yusufElnady/NadyScope/NadyScope.kicad_pcb

## KiCad design NadyScope.kicad_pcb (2026-04-17)

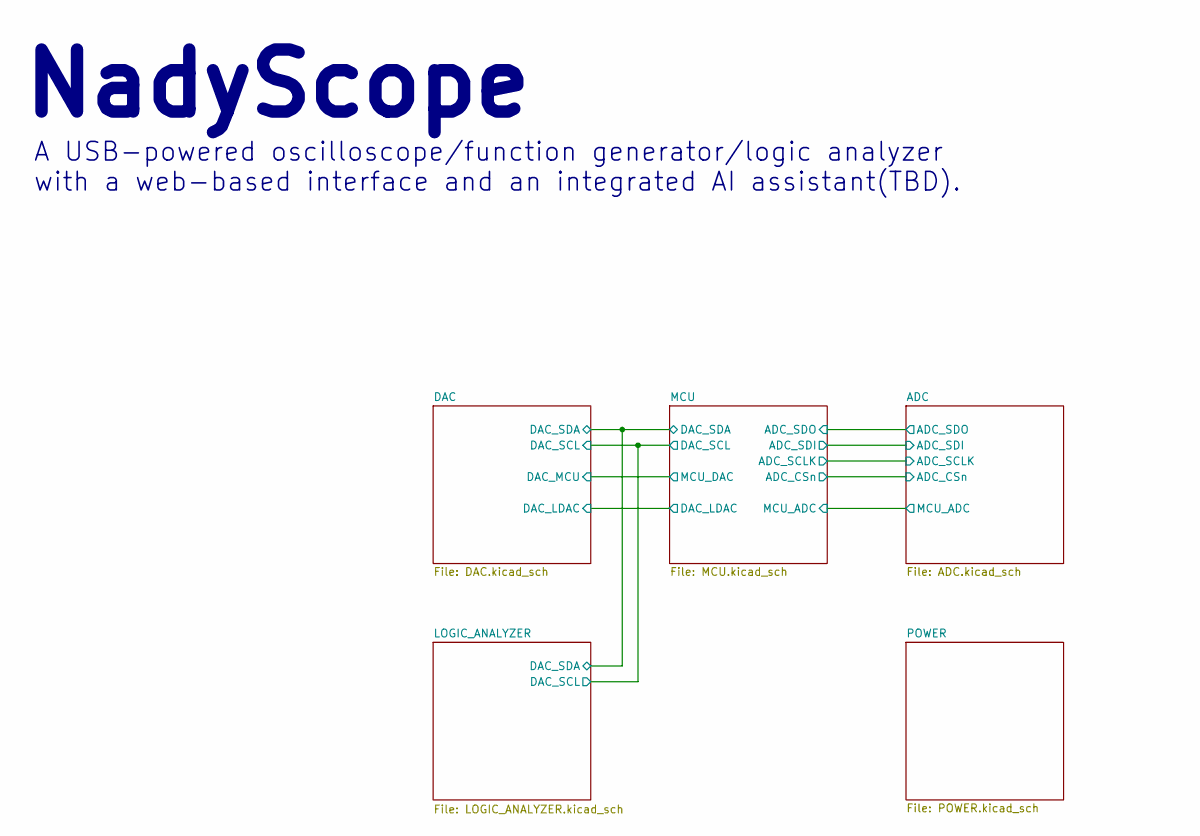
[picture p10: schematic NadyScope.kicad_sch]

Notes on the sheet:
A USB-powered oscilloscope/function generator/logic analyzer with a web-based interface and an integrated AI assistant(TBD).
NadyScope

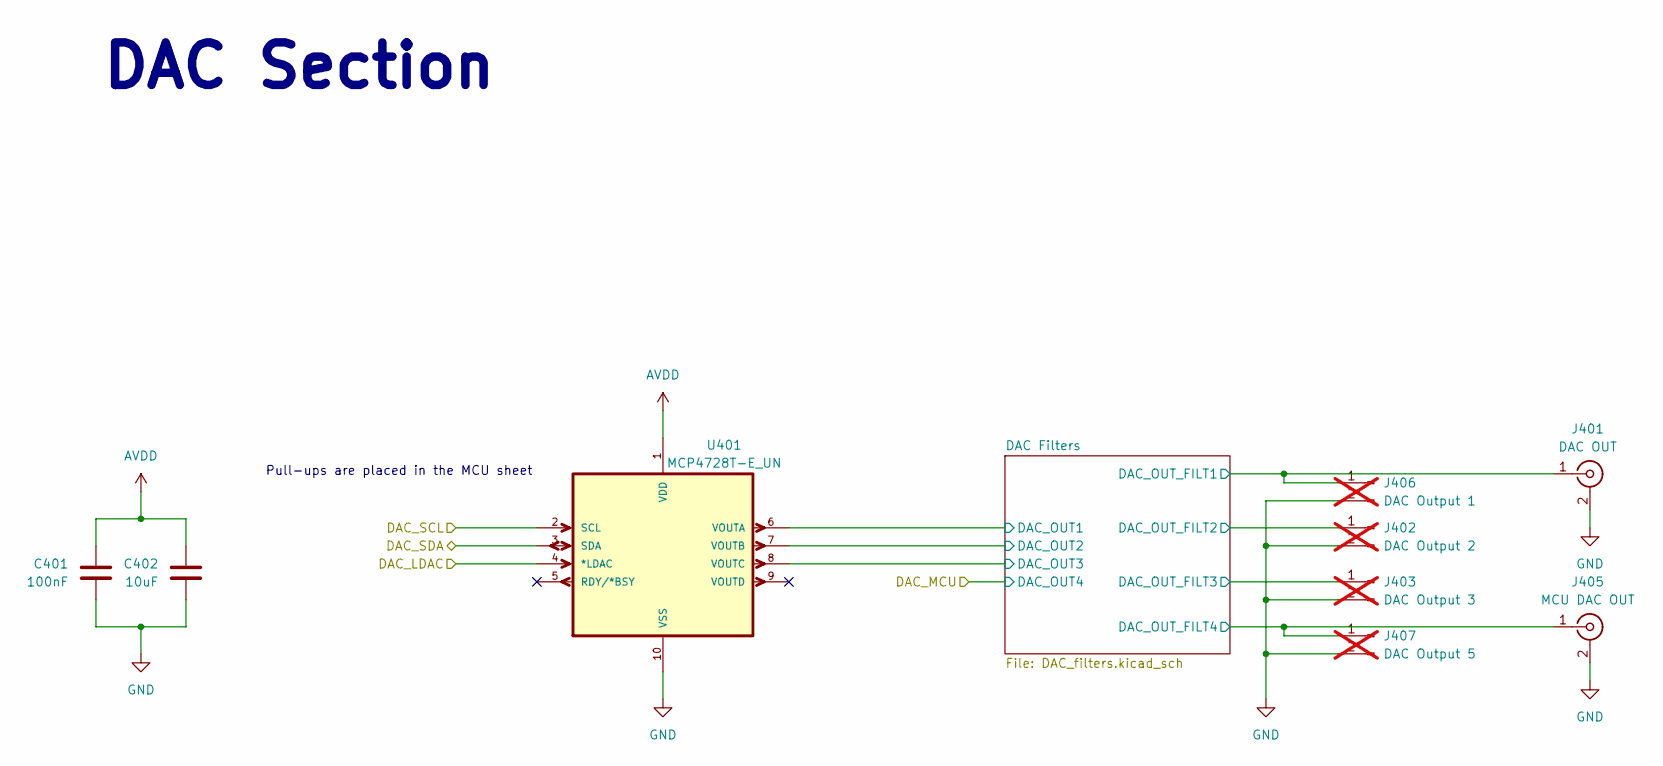
[picture p11: schematic DAC.kicad_sch]

Parts:
C401: 100nF; C_0603_1608Metric; MPN 0603B104M250CT
C402: 10uF; C_0603_1608Metric; MPN CL10A106MP8NNNC
J401: DAC OUT; CONN4_DOSIN-801_DOS; MPN DOSIN-801-0083
J402: DAC Output 2; PinHeader_1x02_P2.54mm_Vertical; not fitted
J403: DAC Output 3; PinHeader_1x02_P2.54mm_Vertical; not fitted
J405: MCU DAC OUT; CONN4_DOSIN-801_DOS; MPN DOSIN-801-0083
J406: DAC Output 1; PinHeader_1x02_P2.54mm_Vertical; not fitted
J407: DAC Output 5; PinHeader_1x02_P2.54mm_Vertical; not fitted
U401: MCP4728T-E_UN; SOP50P490X110-10N; MPN MCP4728T-E/UN

Connections:
/DAC/DAC Filters/DAC_OUT1: U401.6 (VOUTA); also elsewhere on the board
/DAC/DAC Filters/DAC_OUT2: U401.7 (VOUTB); also elsewhere on the board
/DAC/DAC Filters/DAC_OUT3: U401.8 (VOUTC); also elsewhere on the board
/DAC/DAC Filters/DAC_OUT_FILT1: J401.1 (In), J406.1; also elsewhere on the board
/DAC/DAC Filters/DAC_OUT_FILT2: J402.1; also elsewhere on the board
/DAC/DAC Filters/DAC_OUT_FILT3: J403.1; also elsewhere on the board
/DAC/DAC Filters/DAC_OUT_FILT4: J405.1 (In), J407.1; also elsewhere on the board
/DAC/DAC_LDAC: U401.4 (*LDAC); also elsewhere on the board
/DAC/DAC_SCL: U401.2 (SCL); also elsewhere on the board
/DAC/DAC_SDA: U401.3 (SDA); also elsewhere on the board
AVDD: C401.1, C402.1, U401.1 (VDD); also elsewhere on the board
GND: C401.2, C402.2, J401.2 (Ext), J402.2, J403.2, J405.2 (Ext), J406.2, J407.2, U401.10 (VSS); also elsewhere on the board

Notes on the sheet:
DAC Section
Pull-ups are placed in the MCU sheet

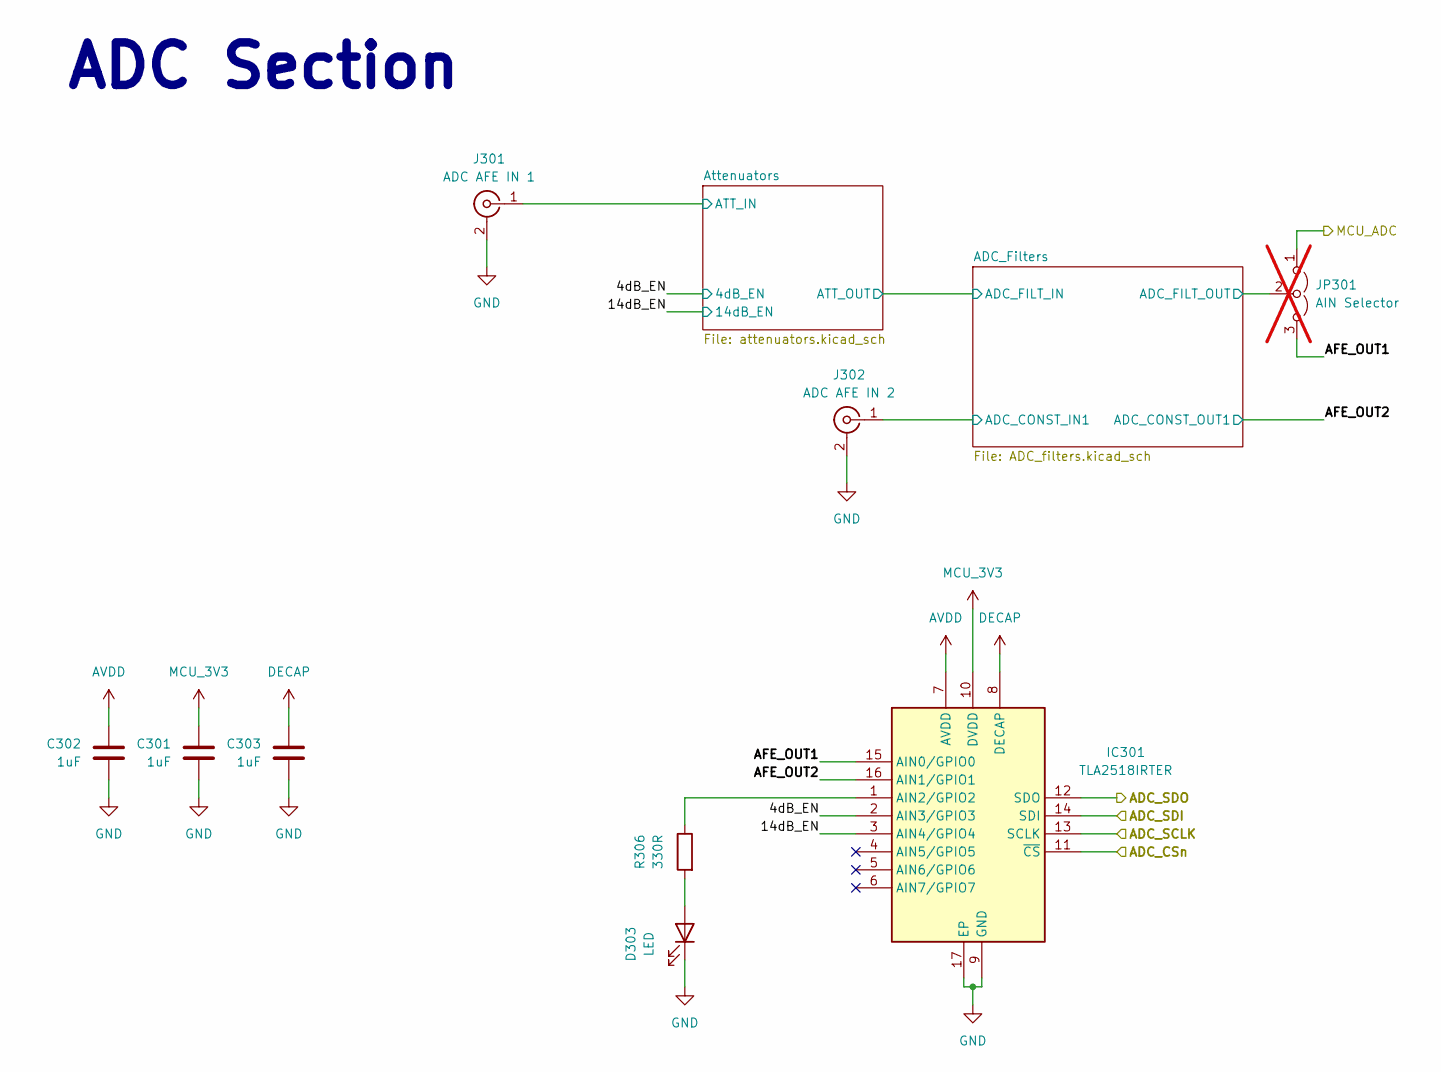
[picture p12: schematic ADC.kicad_sch, Input Analog Frontend Section]

Parts:
C301, C302, C303: 1uF; C_0603_1608Metric; MPN 0603X105K250CT
D303: LED; LED_0805_2012Metric
IC301: TLA2518IRTER; QFN50P300X300X80-17N-D; Manufacturer_Part_Number TLA2518IRTER; Mouser Part Number 595-TLA2518IRTER
J301: ADC AFE IN 1; CONN4_DOSIN-801_DOS; MPN DOSIN-801-0083
J302: ADC AFE IN 2; CONN4_DOSIN-801_DOS; MPN DOSIN-801-0083
JP301: AIN Selector; SolderJumper-3_P1.3mm_Open_Pad1.0x1.5mm; not fitted
R306: 330R; R_0603_1608Metric; MPN TD03G3300BT

Connections:
/ADC/4dB_EN: IC301.2 (AIN3/GPIO3); also elsewhere on the board
/ADC/14dB_EN: IC301.3 (AIN4/GPIO4); also elsewhere on the board
/ADC/ADC_CSn: IC301.11 (~CS); also elsewhere on the board
/ADC/ADC_Filters/ADC_FILT_OUT: JP301.2 (C); also elsewhere on the board
/ADC/ADC_SCLK: IC301.13 (SCLK); also elsewhere on the board
/ADC/ADC_SDI: IC301.14 (SDI); also elsewhere on the board
/ADC/ADC_SDO: IC301.12 (SDO); also elsewhere on the board
/ADC/AFE_OUT1: IC301.15 (AIN0/GPIO0), JP301.3 (B)
/ADC/AFE_OUT2: IC301.16 (AIN1/GPIO1); also elsewhere on the board
/ADC/MCU_ADC: JP301.1 (A); also elsewhere on the board
AVDD: C302.1, IC301.7 (AVDD); also elsewhere on the board
DECAP: C303.1, IC301.8 (DECAP)
GND: C301.2, C302.2, C303.2, D303.1 (K), IC301.9 (GND), IC301.17 (EP), J301.2 (Ext), J302.2 (Ext); also elsewhere on the board
MCU_3V3: C301.1, IC301.10 (DVDD); also elsewhere on the board
unnamed: D303.2 (A), R306.2
unnamed: IC301.1 (AIN2/GPIO2), R306.1

Notes on the sheet:
ADC Section

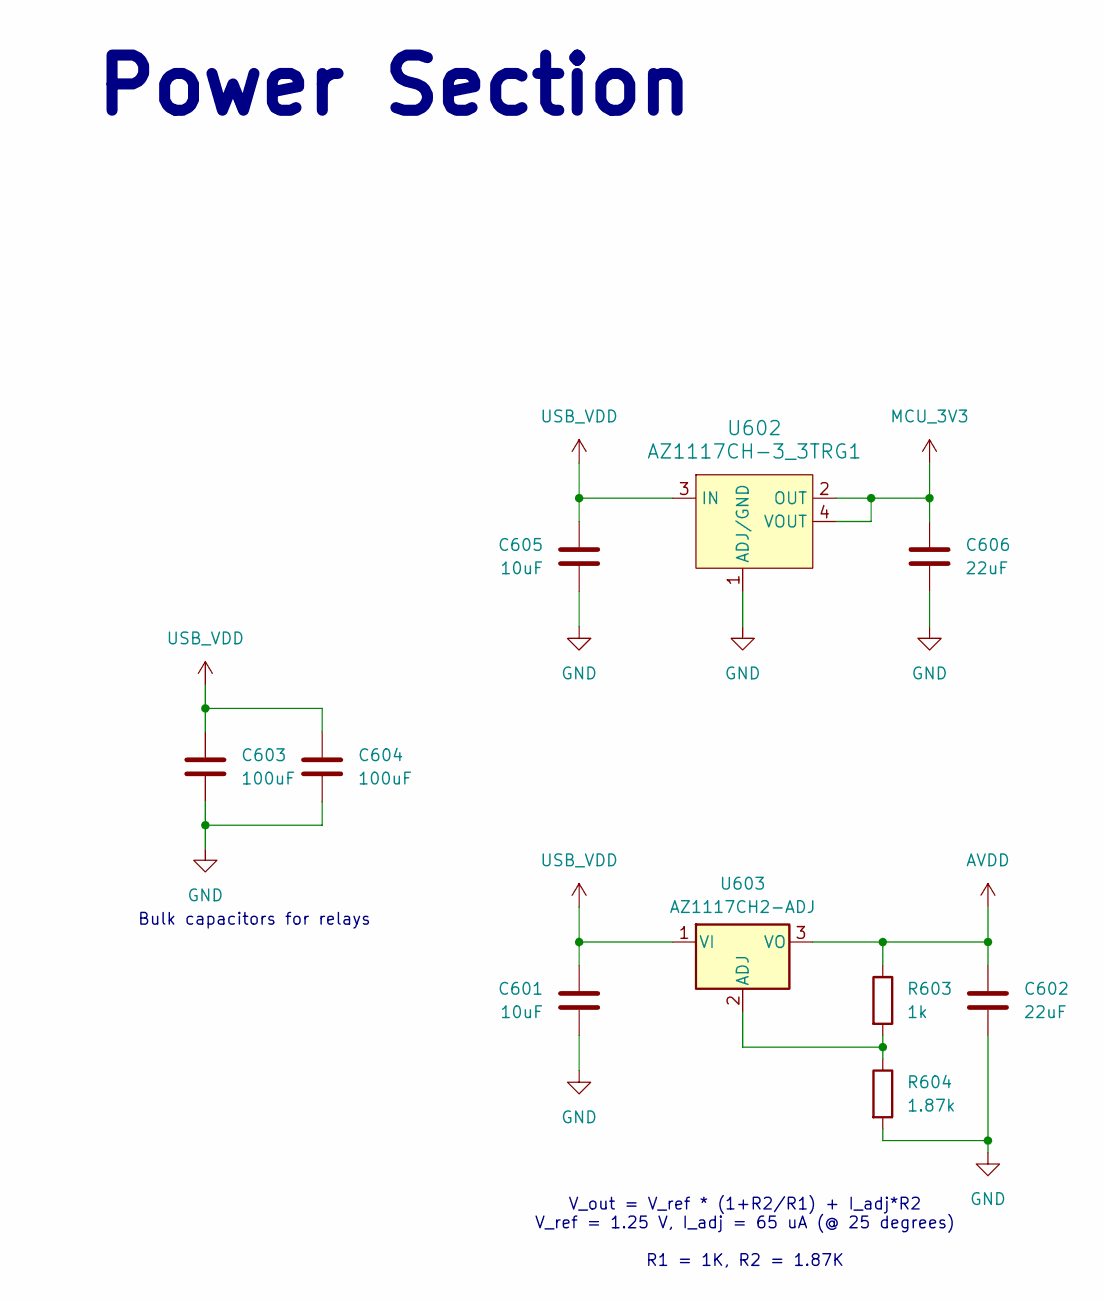
[picture p13: schematic POWER.kicad_sch]

Parts:
C601, C605: 10uF; C_0805_2012Metric; MPN CL21A106KOQNNNE
C602, C606: 22uF; C_0805_2012Metric; MPN CL21X226MRQNNNE
C603, C604: 100uF; C_1206_3216Metric; MPN TCC1206X7R103M501DTS
R603: 1k; R_0603_1608Metric; MPN RT0603BRD071KL
R604: 1.87k; R_0603_1608Metric; MPN PTFR0603B1K87N9
U602: AZ1117CH-3_3TRG1; SOT-223; MPN AZ1117CH-3.3TRG1; Digi-Key_PN AZ1117CH-3.3TRG1DICT-ND
U603: AZ1117CH2-ADJ; SOT-223-3_TabPin2; MPN AZ1117CH2-ADJ

Connections:
AVDD: C602.1, R603.1, U603.3 (VO); also elsewhere on the board
GND: C601.2, C602.2, C603.2, C604.2, C605.2, C606.2, R604.2, U602.1 (ADJ/GND); also elsewhere on the board
MCU_3V3: C606.1, U602.2 (OUT), U602.4 (VOUT); also elsewhere on the board
unnamed: R603.2, R604.1, U603.2 (ADJ)
USB_VDD: C601.1, C603.1, C604.1, C605.1, U602.3 (IN), U603.1 (VI); also elsewhere on the board

Notes on the sheet:
Bulk capacitors for relays
V_out = V_ref * (1+R2/R1) + I_adj*R2 V_ref = 1.25 V, I_adj = 65 uA (@ 25 degrees) R1 = 1K, R2 = 1.87K
Power Section

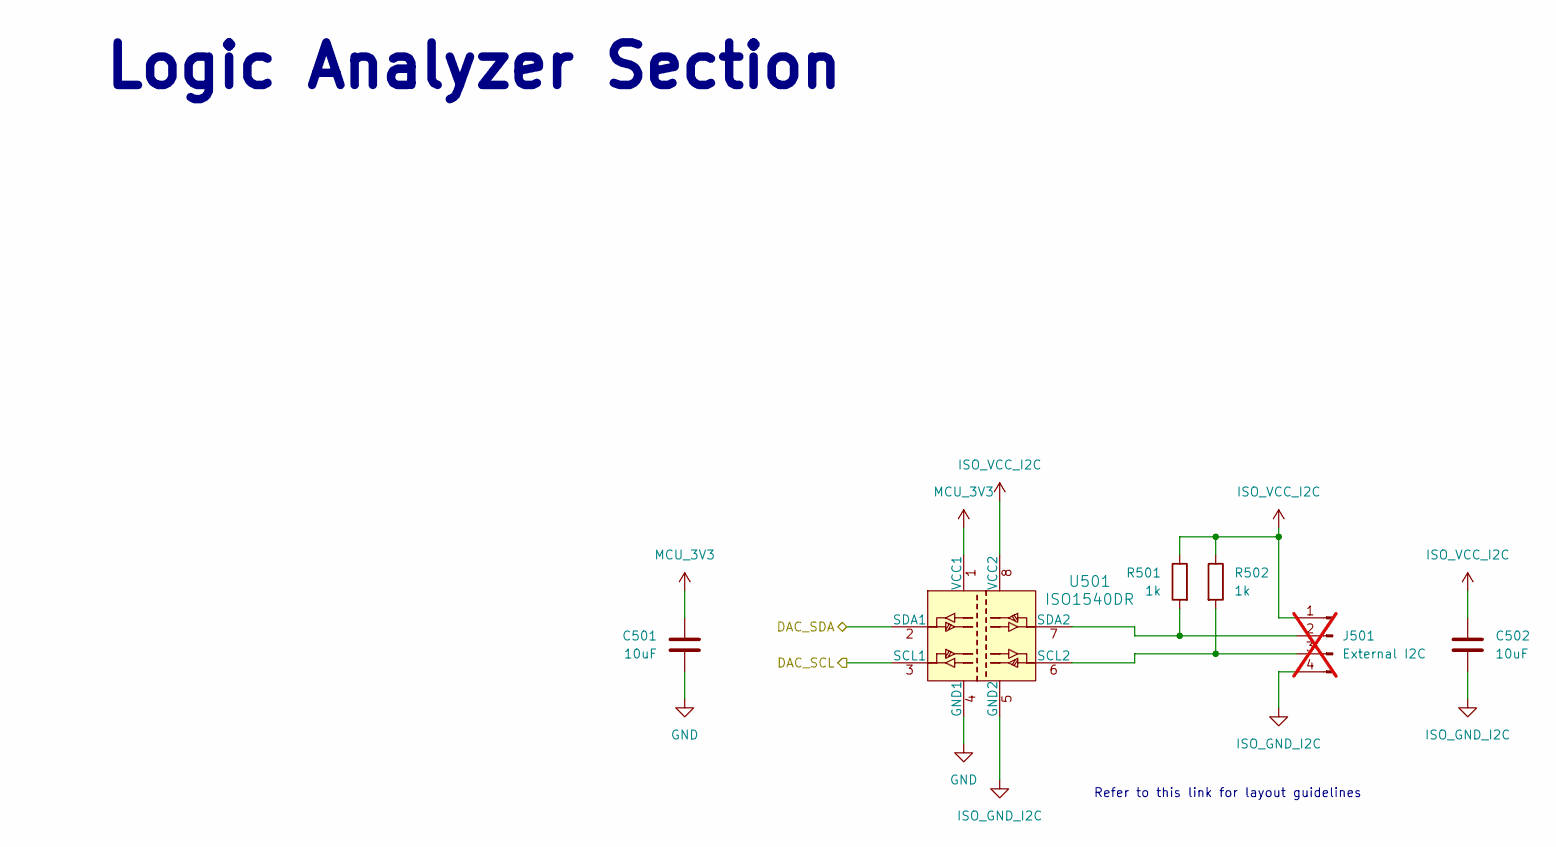
[picture p14: schematic LOGIC_ANALYZER.kicad_sch]

Parts:
C501, C502: 10uF; C_0603_1608Metric; MPN CL10A106MP8NNNC
J501: External I2C; PinHeader_1x04_P2.54mm_Vertical; not fitted
R501, R502: 1k; R_0603_1608Metric; MPN RT0603BRD071KL
U501: ISO1540DR; SOIC-8_W3.9mm; MPN ISO1540DR; Digi-Key_PN 296-34871-1-ND

Connections:
/DAC/DAC_SCL: U501.3 (SCL1); also elsewhere on the board
/DAC/DAC_SDA: U501.2 (SDA1); also elsewhere on the board
GND: C501.2, U501.4 (GND1); also elsewhere on the board
ISO_GND_I2C: C502.2, J501.4, U501.5 (GND2)
ISO_VCC_I2C: C502.1, J501.1, R501.1, R502.1, U501.8 (VCC2)
MCU_3V3: C501.1, U501.1 (VCC1); also elsewhere on the board
unnamed: J501.2, R501.2, U501.7 (SDA2)
unnamed: J501.3, R502.2, U501.6 (SCL2)

Notes on the sheet:
Logic Analyzer Section
Refer to this link for layout guidelines

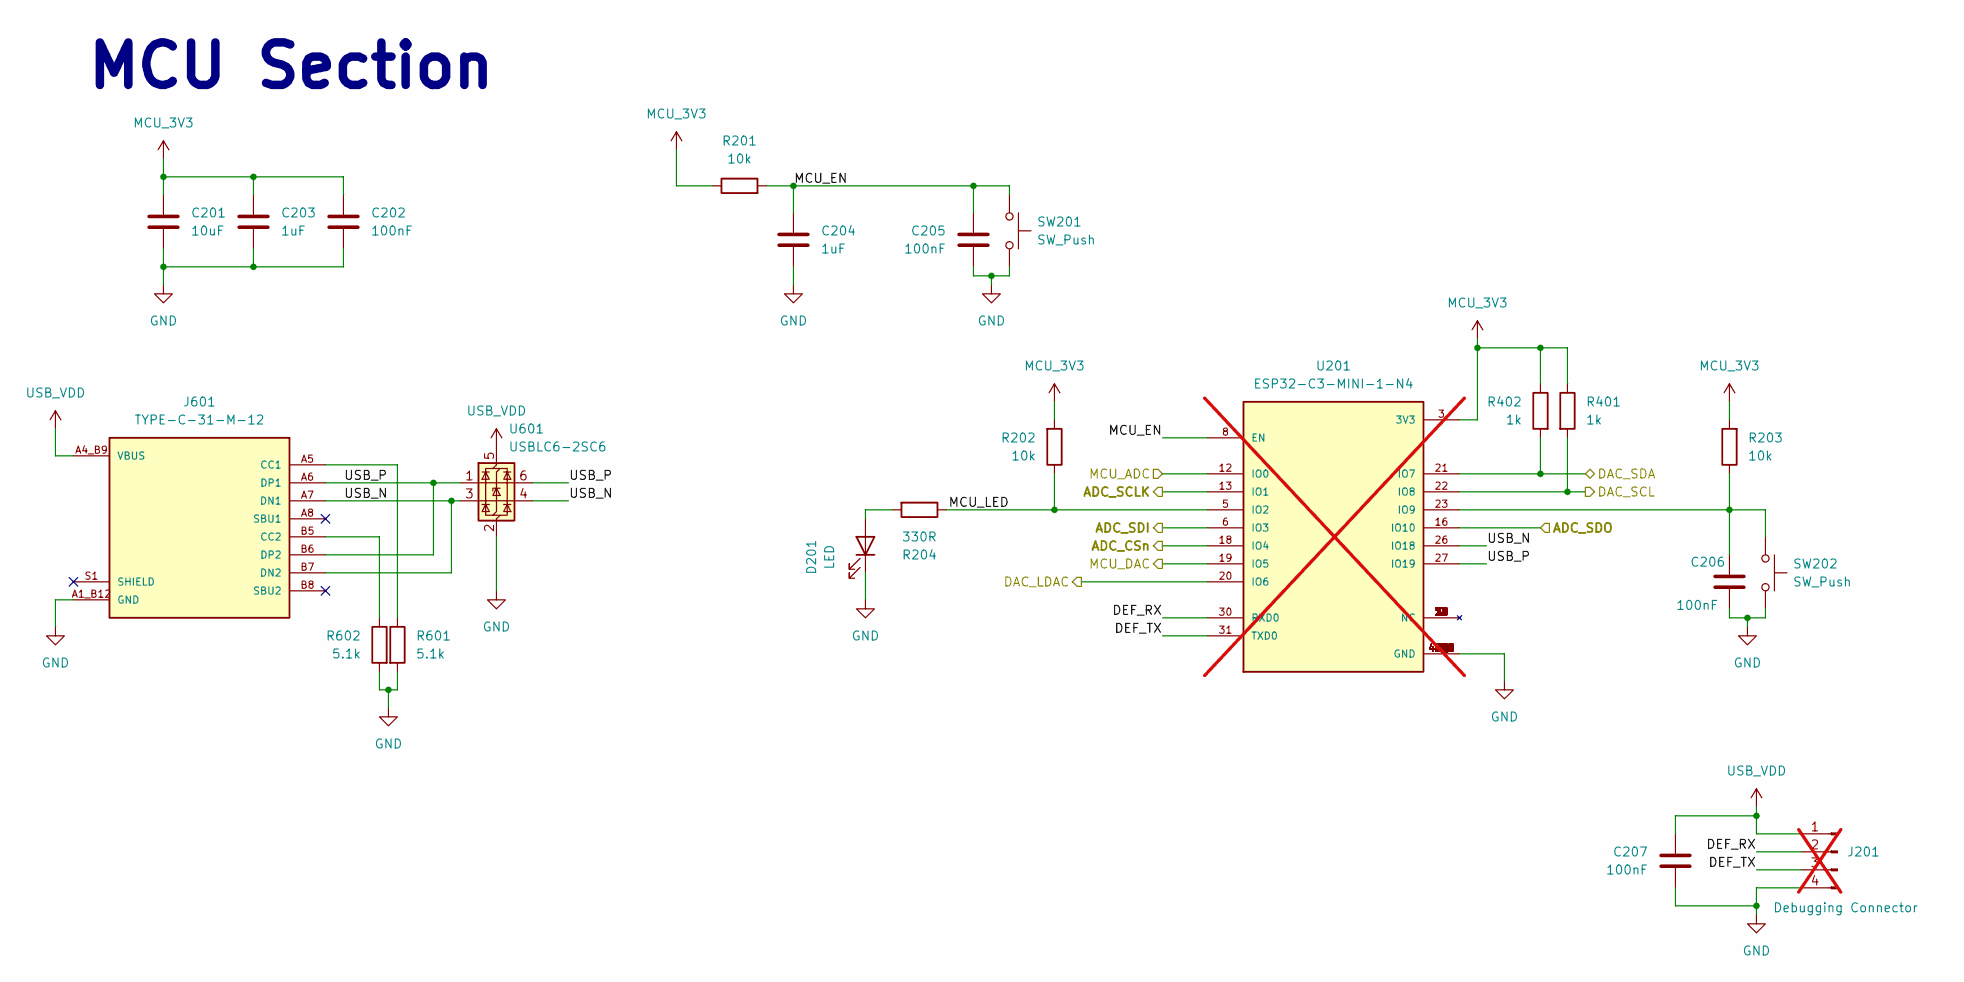
[picture p15: schematic MCU.kicad_sch]

Parts:
C201: 10uF; C_0603_1608Metric; MPN CL10A106MP8NNNC
C202, C205, C206, C207: 100nF; C_0603_1608Metric; MPN 0603B104M250CT
C203, C204: 1uF; C_0603_1608Metric; MPN 0603X105K250CT
D201: LED; LED_0805_2012Metric
J201: Debugging Connector; PinHeader_1x04_P2.54mm_Vertical; not fitted
J601: TYPE-C-31-M-12; HRO_TYPE-C-31-M-12; PARTREV 2020.12.08
R201, R202, R203: 10k; R_0603_1608Metric; MPN TD03G1002BT
R204: 330R; R_0603_1608Metric; MPN TD03G3300BT
R401, R402: 1k; R_0603_1608Metric; MPN RT0603BRD071KL
R601, R602: 5.1k; R_0603_1608Metric; MPN RT0603BRD075K1L
SW201, SW202: SW_Push; SW_Push_SPST_NO_Alps_SKRK
U201: ESP32-C3-MINI-1-N4; XCVR_ESP32-C3-MINI-1-N4; PARTREV v1.0; not fitted
U601: USBLC6-2SC6; SOT-23-6; MPN USBLC6-2SC6

Connections:
/ADC/ADC_CSn: U201.18 (IO4); also elsewhere on the board
/ADC/ADC_SCLK: U201.13 (IO1); also elsewhere on the board
/ADC/ADC_SDI: U201.6 (IO3); also elsewhere on the board
/ADC/ADC_SDO: U201.16 (IO10); also elsewhere on the board
/ADC/MCU_ADC: U201.12 (IO0); also elsewhere on the board
/DAC/DAC_LDAC: U201.20 (IO6); also elsewhere on the board
/DAC/DAC_MCU: U201.19 (IO5); also elsewhere on the board
/DAC/DAC_SCL: R401.2, U201.22 (IO8); also elsewhere on the board
/DAC/DAC_SDA: R402.2, U201.21 (IO7); also elsewhere on the board
/MCU/DEF_RX: J201.2, U201.30 (RXD0)
/MCU/DEF_TX: J201.3, U201.31 (TXD0)
/MCU/MCU_EN: C204.1, C205.1, R201.2, SW201.1, U201.8 (EN)
/MCU/MCU_LED: R202.1, R204.1, U201.5 (IO2)
/MCU/USB_N: J601.A7 (DN1), J601.B7 (DN2), U201.26 (IO18), U601.3 (I/O2), U601.4 (I/O2)
/MCU/USB_P: J601.A6 (DP1), J601.B6 (DP2), U201.27 (IO19), U601.1 (I/O1), U601.6 (I/O1)
GND: C201.2, C202.2, C203.2, C204.2, C205.2, C206.2, C207.2, D201.1 (K), J201.4, J601.A1_B12 (GND), J601.B1_A12 (GND), R601.2, R602.2, SW201.2, SW202.2, U201.1 (GND), U201.2 (GND), U201.11 (GND), U201.14 (GND), U201.36 (GND), U201.37 (GND), U201.38 (GND), U201.39 (GND), U201.40 (GND), U201.41 (GND), U201.42 (GND), U201.43 (GND), U201.44 (GND), U201.45 (GND), U201.46 (GND), U201.47 (GND), U201.48 (GND), U201.49_1 (GND), U201.49_2 (GND), U201.49_3 (GND), U201.49_4 (GND), U201.49_5 (GND), U201.49_6 (GND), U201.49_7 (GND), U201.49_8 (GND), U201.49_9 (GND), U201.50 (GND), U201.51 (GND), U201.52 (GND), U201.53 (GND), U601.2 (GND); also elsewhere on the board
MCU_3V3: C201.1, C202.1, C203.1, R201.1, R202.2, R203.2, R401.1, R402.1, U201.3 (3V3); also elsewhere on the board
unnamed: D201.2 (A), R204.2
unnamed: J601.A5 (CC1), R601.1
unnamed: J601.B5 (CC2), R602.1
unnamed: C206.1, R203.1, SW202.1, U201.23 (IO9)
USB_VDD: C207.1, J201.1, J601.A4_B9 (VBUS), J601.B4_A9 (VBUS), U601.5 (VBUS); also elsewhere on the board

Notes on the sheet:
MCU Section

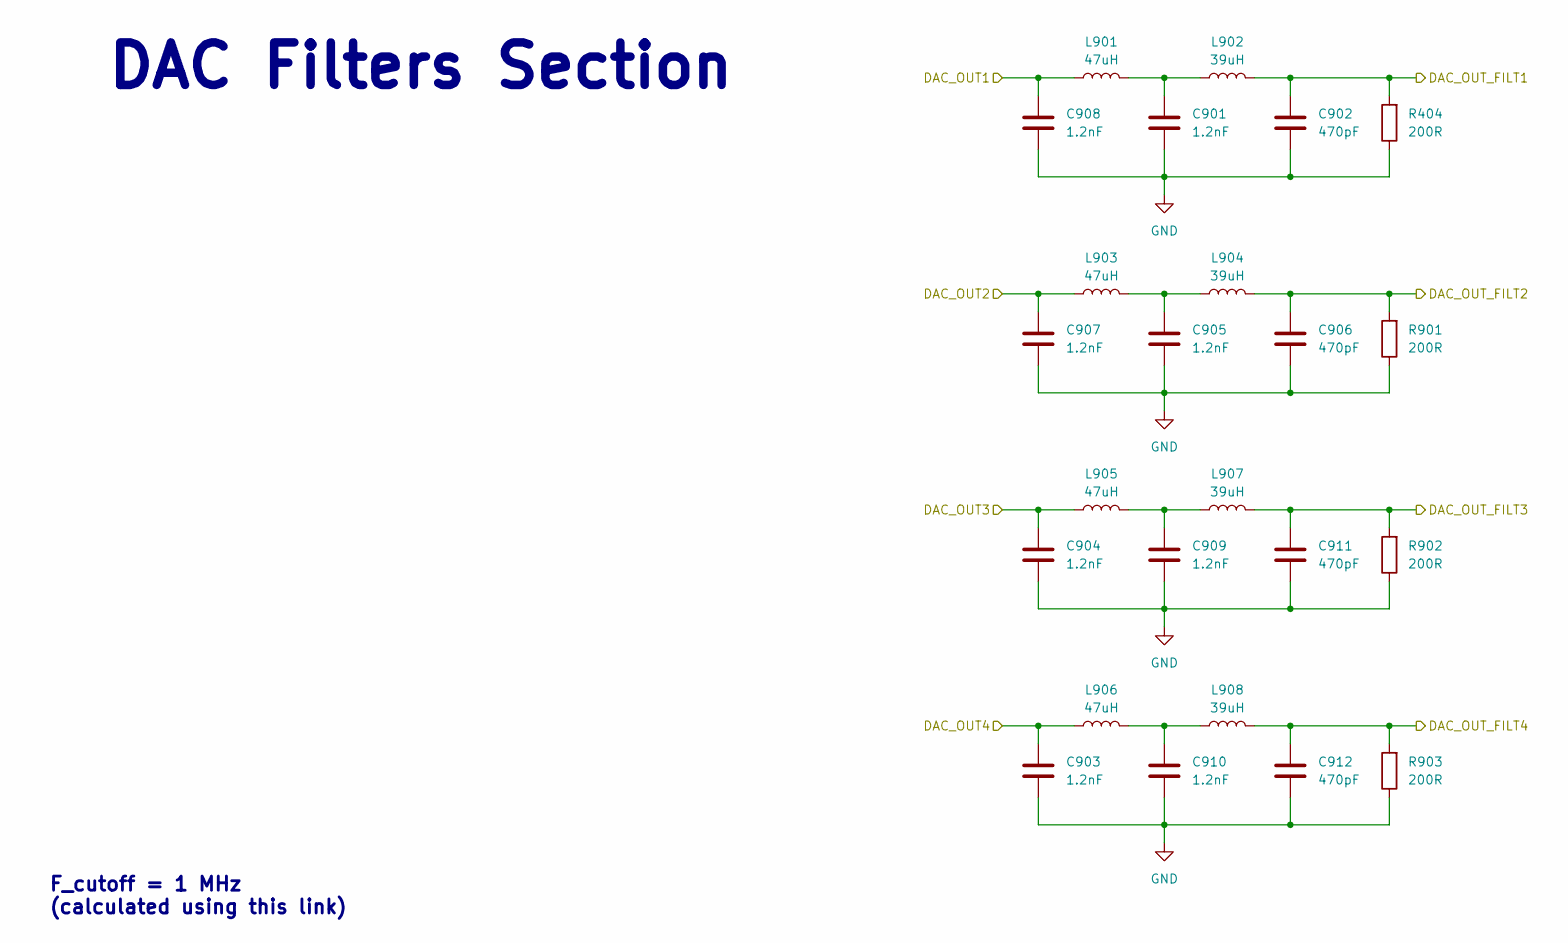
[picture p16: schematic DAC_filters.kicad_sch]

Parts:
C901, C903, C904, C905, C907, C908, C909, C910: 1.2nF; C_0603_1608Metric; MPN CGA0603X7R122K500JT
C902, C906, C911, C912: 470pF; C_0603_1608Metric; MPN FCC0603B471K500CT
L901, L903, L905, L906: 47uH; L_0603_1608Metric; MPN WI0603LD470KST-HF
L902, L904, L907, L908: 39uH; L_0805_2012Metric; MPN MLI2012F-390KT
R404, R901, R902, R903: 200R; R_0603_1608Metric; MPN PTFR0603B200RP9

Connections:
/DAC/DAC Filters/DAC_OUT1: C908.1, L901.1; also elsewhere on the board
/DAC/DAC Filters/DAC_OUT2: C907.1, L903.1; also elsewhere on the board
/DAC/DAC Filters/DAC_OUT3: C904.1, L905.1; also elsewhere on the board
/DAC/DAC Filters/DAC_OUT_FILT1: C902.1, L902.2, R404.2; also elsewhere on the board
/DAC/DAC Filters/DAC_OUT_FILT2: C906.1, L904.2, R901.2; also elsewhere on the board
/DAC/DAC Filters/DAC_OUT_FILT3: C911.1, L907.2, R902.2; also elsewhere on the board
/DAC/DAC Filters/DAC_OUT_FILT4: C912.1, L908.2, R903.2; also elsewhere on the board
/DAC/DAC_MCU: C903.1, L906.1; also elsewhere on the board
GND: C901.2, C902.2, C903.2, C904.2, C905.2, C906.2, C907.2, C908.2, C909.2, C910.2, C911.2, C912.2, R404.1, R901.1, R902.1, R903.1; also elsewhere on the board
unnamed: C901.1, L901.2, L902.1
unnamed: C905.1, L903.2, L904.1
unnamed: C909.1, L905.2, L907.1
unnamed: C910.1, L906.2, L908.1

Notes on the sheet:
F_cutoff = 1 MHz (calculated using this link)
DAC Filters Section

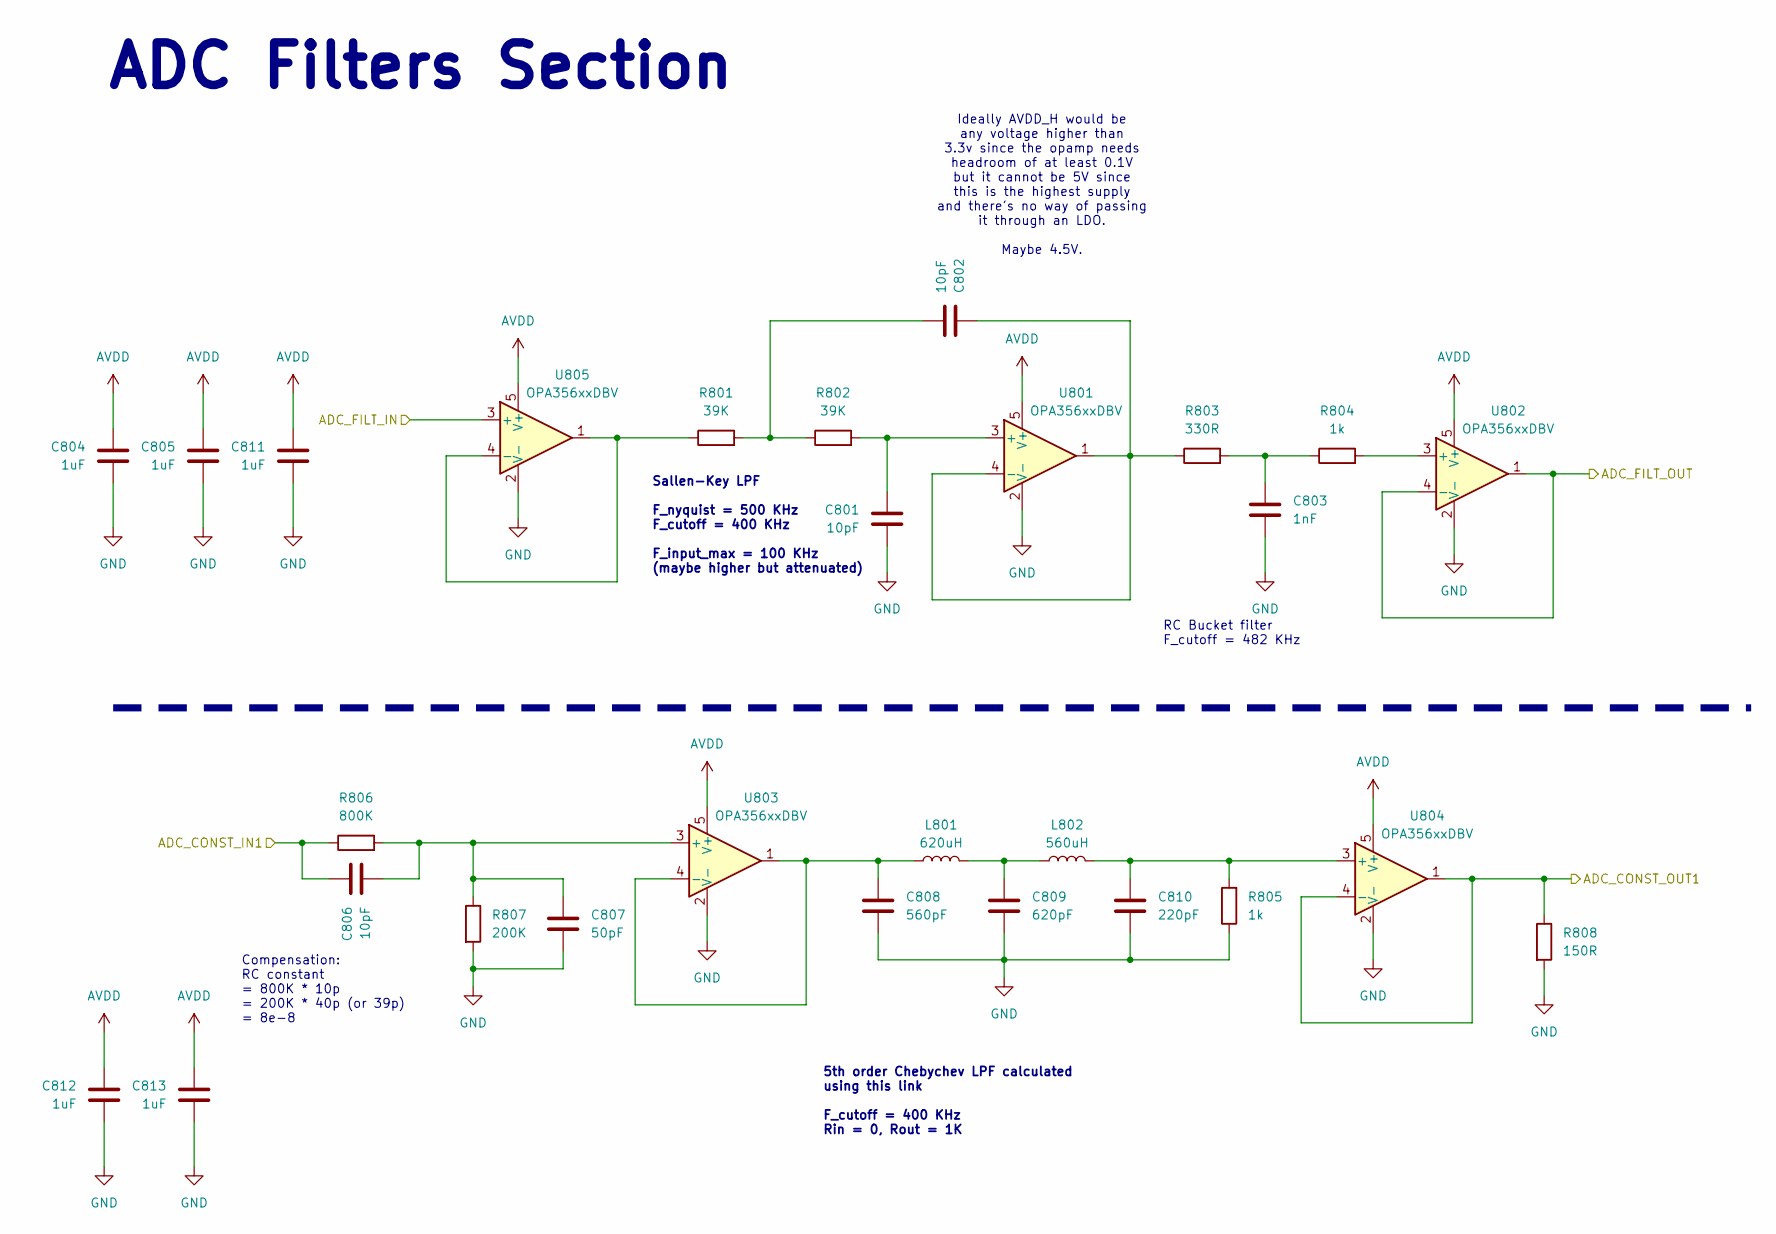
[picture p17: schematic ADC_filters.kicad_sch]

Parts:
C801, C802, C806: 10pF; C_0603_1608Metric; MPN FCC0603N100J500CT
C803: 1nF; C_0603_1608Metric; MPN CL10B102KB8NNNC
C804, C805, C811, C812, C813: 1uF; C_0603_1608Metric; MPN 0603X105K250CT
C807: 50pF; C_0603_1608Metric; MPN CC0603JRNPO9BN510
C808: 560pF; C_0603_1608Metric; MPN TCC0603X7R561K500CT
C809: 620pF; C_0603_1608Metric; MPN CC0603JRNPO9BN621
C810: 220pF; C_0603_1608Metric; MPN CS1608X7R221K500NRB
L801: 620uH; L_1210_3225Metric; MPN MWI1210IF621KST-HF
L802: 560uH; L_1210_3225Metric; MPN AHW3225F-561KTF
R801, R802: 39K; R_0603_1608Metric; MPN RT0603BRD0739KL
R803: 330R; R_0603_1608Metric; MPN TD03G3300BT
R804, R805: 1k; R_0603_1608Metric; MPN RT0603BRD071KL
R806: 800K; R_0603_1608Metric; MPN HoARG0603-1/10W-820KR-0.1%-TCR25
R807: 200K; R_0603_1608Metric; MPN ERA3AEB204V
R808: 150R; R_0603_1608Metric; MPN RT0603BRD07150RL
U801, U802, U803, U804, U805: OPA356xxDBV; SOT-23-5

Connections:
/ADC/ADC_Filters/ADC_CONST_IN1: C806.1, R806.1; also elsewhere on the board
/ADC/ADC_Filters/ADC_FILT_IN: U805.3 (+); also elsewhere on the board
/ADC/ADC_Filters/ADC_FILT_OUT: U802.1, U802.4 (-); also elsewhere on the board
/ADC/AFE_OUT2: R808.1, U804.1, U804.4 (-); also elsewhere on the board
AVDD: C804.1, C805.1, C811.1, C812.1, C813.1, U801.5 (V+), U802.5 (V+), U803.5 (V+), U804.5 (V+), U805.5 (V+); also elsewhere on the board
GND: C801.2, C803.2, C804.2, C805.2, C807.2, C808.2, C809.2, C810.2, C811.2, C812.2, C813.2, R805.1, R807.2, R808.2, U801.2 (V-), U802.2 (V-), U803.2 (V-), U804.2 (V-), U805.2 (V-); also elsewhere on the board
unnamed: C802.2, R801.2, R802.1
unnamed: C803.1, R803.2, R804.1
unnamed: C809.1, L801.2, L802.1
unnamed: C801.1, R802.2, U801.3 (+)
unnamed: C802.1, R803.1, U801.1, U801.4 (-)
unnamed: R804.2, U802.3 (+)
unnamed: C806.2, C807.1, R806.2, R807.1, U803.3 (+)
unnamed: C808.1, L801.1, U803.1, U803.4 (-)
unnamed: C810.1, L802.2, R805.2, U804.3 (+)
unnamed: R801.1, U805.1, U805.4 (-)

Notes on the sheet:
Compensation: RC constant = 800K * 10p = 200K * 40p (or 39p) = 8e-8
Ideally AVDD_H would be any voltage higher than 3.3v since the opamp needs headroom of at least 0.1V but it cannot be 5V since this is the highest supply and there's no way of passing it through an LDO. Maybe 4.5V.
ADC Filters Section
RC Bucket filter F_cutoff = 482 KHz
Sallen-Key LPF F_nyquist = 500 KHz F_cutoff = 400 KHz F_input_max = 100 KHz (maybe higher but attenuated)
5th order Chebychev LPF calculated using this link F_cutoff = 400 KHz Rin = 0, Rout = 1K

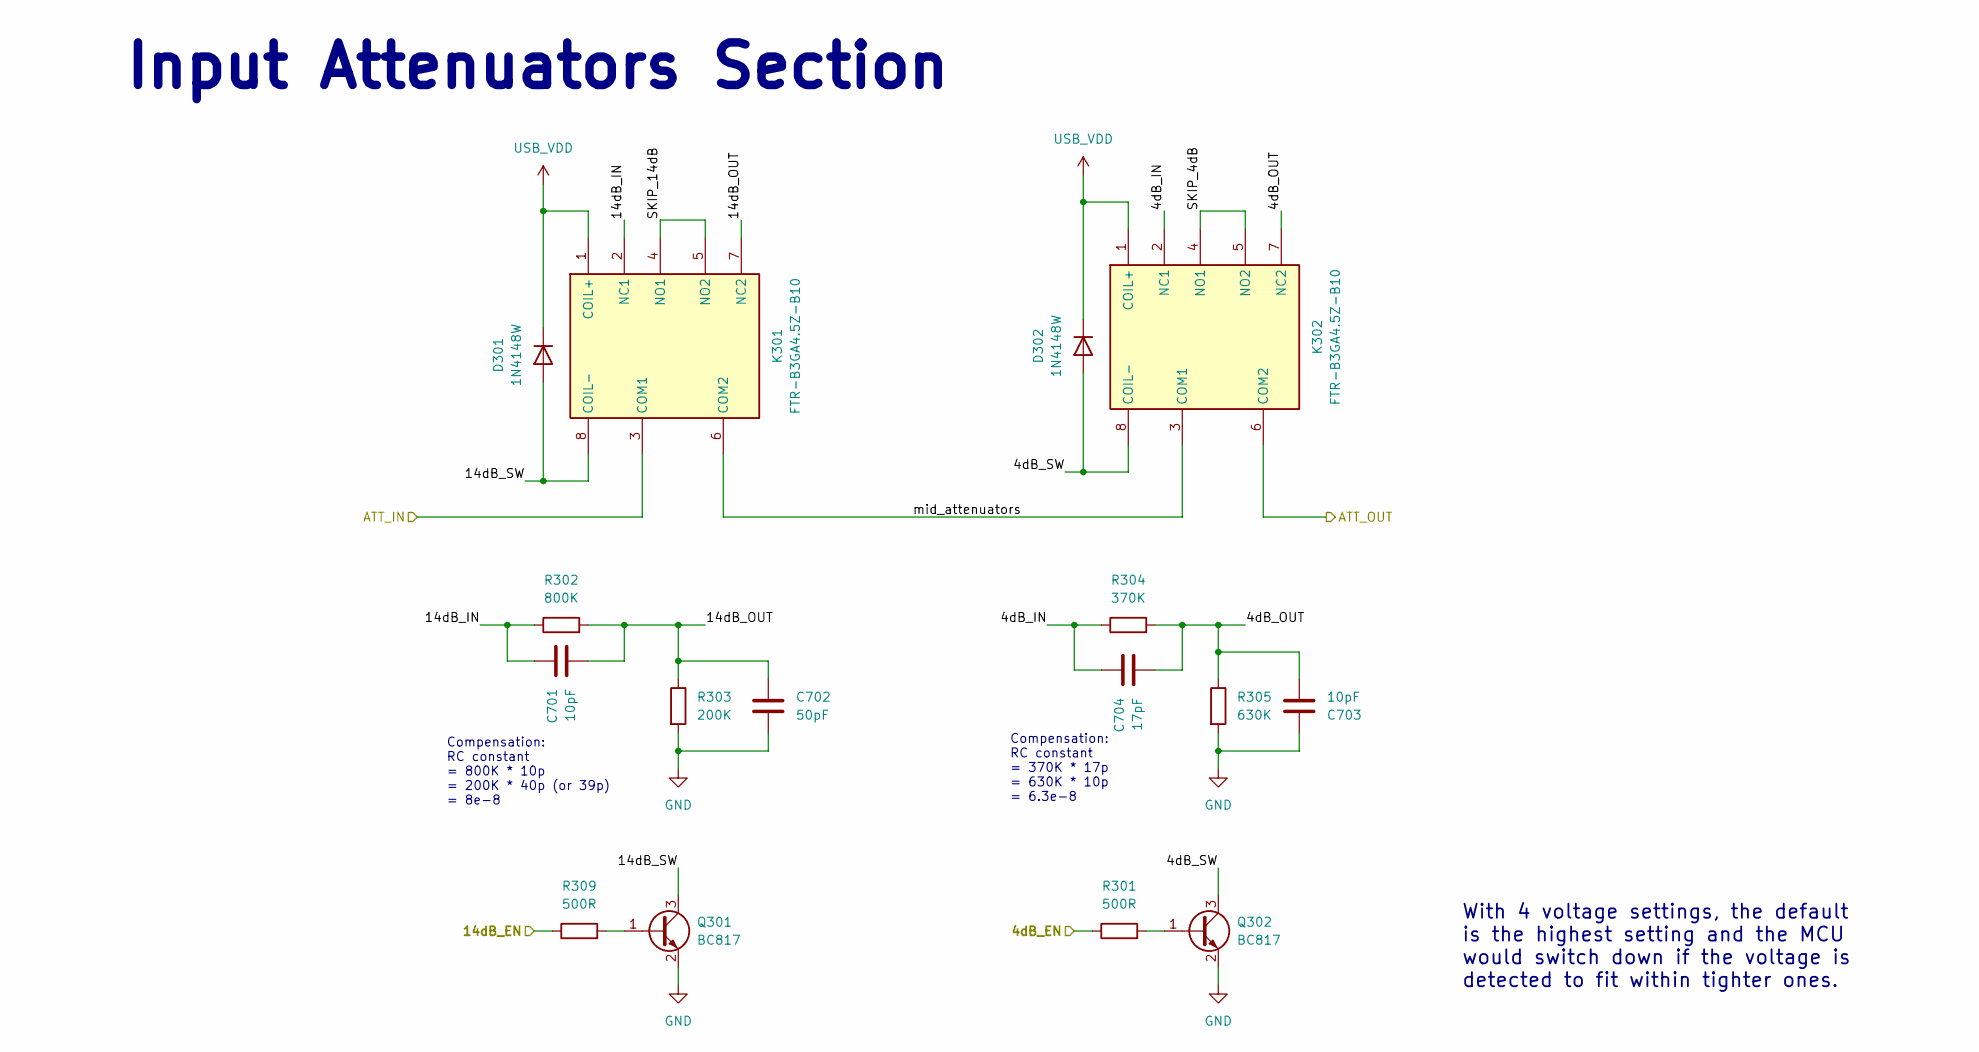
[picture p18: schematic attenuators.kicad_sch]

Parts:
C701, C703: 10pF; C_0603_1608Metric; MPN FCC0603N100J500CT
C702: 50pF; C_0603_1608Metric; MPN CC0603JRNPO9BN510
C704: 17pF; C_0603_1608Metric; MPN 0603N180J500CT
D301, D302: 1N4148W; D_SOD-123; MPN 1N4148W
K301, K302: FTR-B3GA4.5Z-B10; FTRB3GA45ZB10; Manufacturer_Part_Number FTR-B3GA4.5Z-B10
Q301, Q302: BC817; SOT-23; MPN BC817
R301, R309: 500R; R_0603_1608Metric; MPN RT0603BRD07500RL
R302: 800K; R_0603_1608Metric; MPN HoARG0603-1/10W-820KR-0.1%-TCR25
R303: 200K; R_0603_1608Metric; MPN ERA3AEB204V
R304: 370K; R_0603_1608Metric; MPN ARG03BTC3653
R305: 630K; R_0603_1608Metric; MPN ARG03BTC6493

Connections:
/ADC/4dB_EN: R301.1; also elsewhere on the board
/ADC/14dB_EN: R309.1; also elsewhere on the board
/ADC/ADC_Filters/ADC_FILT_IN: K302.6 (COM2); also elsewhere on the board
/ADC/Attenuators/4dB_IN: C704.1, K302.2 (NC1), R304.1
/ADC/Attenuators/4dB_OUT: C703.2, C704.2, K302.7 (NC2), R304.2, R305.1
/ADC/Attenuators/4dB_SW: D302.2 (A), K302.8 (COIL-), Q302.3 (C)
/ADC/Attenuators/14dB_IN: C701.1, K301.2 (NC1), R302.1
/ADC/Attenuators/14dB_OUT: C701.2, C702.1, K301.7 (NC2), R302.2, R303.1
/ADC/Attenuators/14dB_SW: D301.2 (A), K301.8 (COIL-), Q301.3 (C)
/ADC/Attenuators/ATT_IN: K301.3 (COM1); also elsewhere on the board
/ADC/Attenuators/SKIP_4dB: K302.4 (NO1), K302.5 (NO2)
/ADC/Attenuators/SKIP_14dB: K301.4 (NO1), K301.5 (NO2)
/ADC/Attenuators/mid_attenuators: K301.6 (COM2), K302.3 (COM1)
GND: C702.2, C703.1, Q301.2 (E), Q302.2 (E), R303.2, R305.2; also elsewhere on the board
unnamed: Q301.1 (B), R309.2
unnamed: Q302.1 (B), R301.2
USB_VDD: D301.1 (K), D302.1 (K), K301.1 (COIL+), K302.1 (COIL+); also elsewhere on the board

Notes on the sheet:
With 4 voltage settings, the default is the highest setting and the MCU would switch down if the voltage is detected to fit within tighter ones.
Compensation: RC constant = 370K * 17p = 630K * 10p = 6.3e-8
Input Attenuators Section
Compensation: RC constant = 800K * 10p = 200K * 40p (or 39p) = 8e-8
