yusufElnady/NadyScope/NadyScope.kicad_pcb

## KiCad design NadyScope.kicad_pcb (continued)

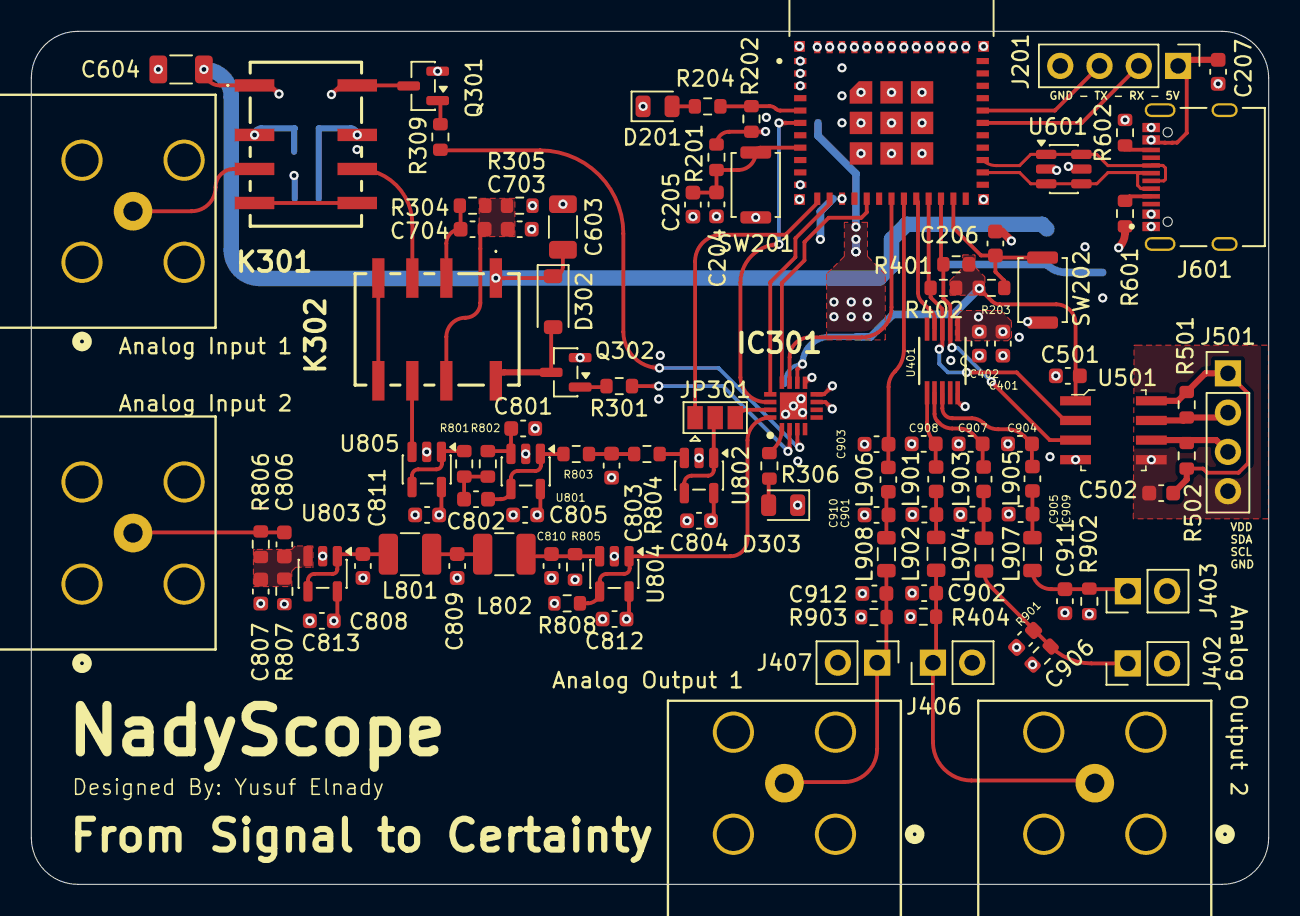
[picture p19: board NadyScope.kicad_pcb from above]

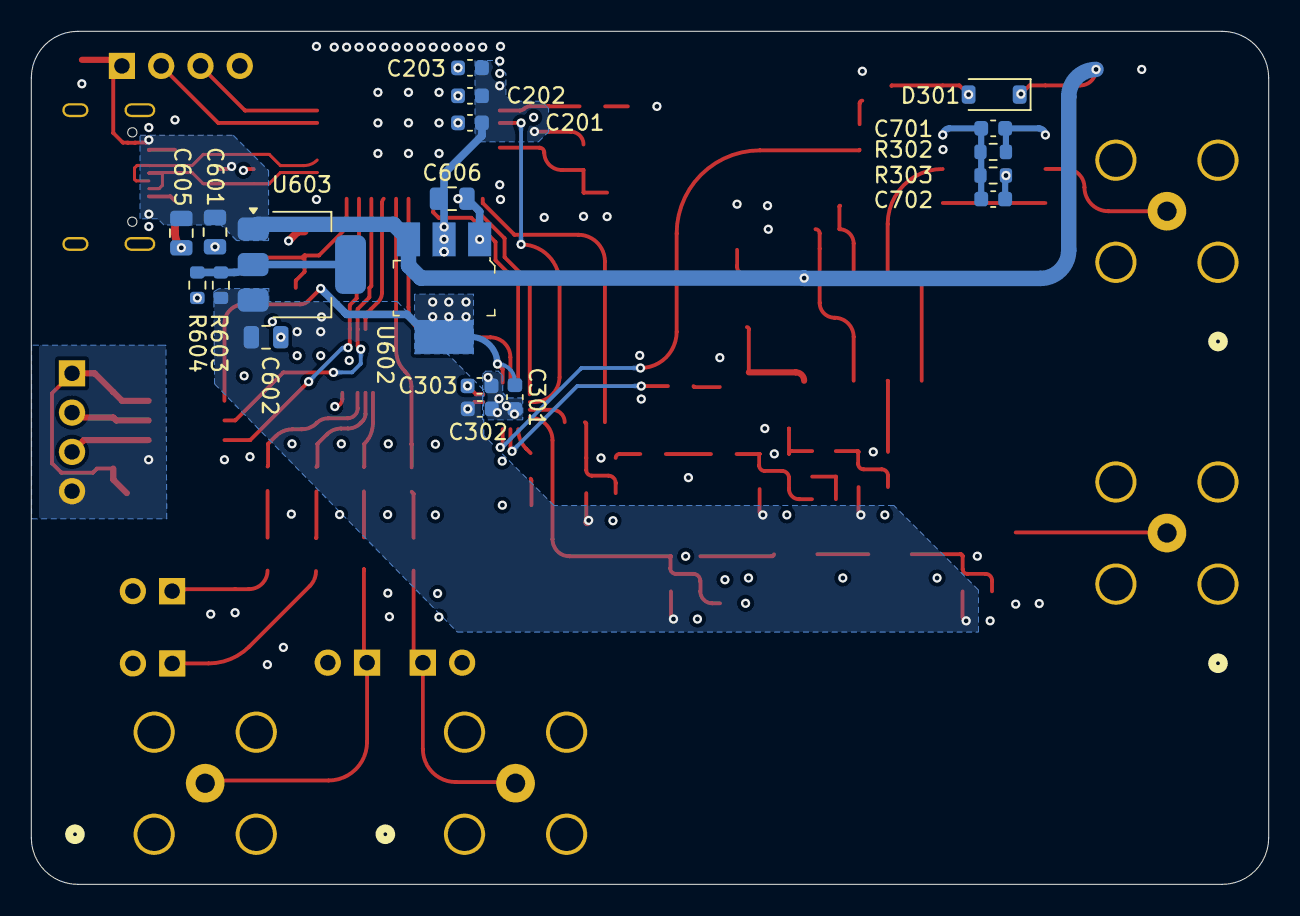
[picture p20: board NadyScope.kicad_pcb from below]

Board: 4 copper layers, 80.0 x 55.2 mm, 124 parts (19 on the bottom side), 71 nets.

Other parts of the board:
Analog Input 1: ADC AFE IN 1; CONN4_DOSIN-801_DOS
Analog Input 2: ADC AFE IN 2; CONN4_DOSIN-801_DOS
Analog Output 1: MCU DAC OUT; CONN4_DOSIN-801_DOS
Analog Output 2: DAC OUT; CONN4_DOSIN-801_DOS

Their connections:
/ADC/ADC_Filters/ADC_CONST_IN1: Analog Input 2.1 (In); also elsewhere on the board
/ADC/Attenuators/ATT_IN: Analog Input 1.1 (In); also elsewhere on the board
/DAC/DAC Filters/DAC_OUT_FILT1: Analog Output 2.1 (In); also elsewhere on the board
/DAC/DAC Filters/DAC_OUT_FILT4: Analog Output 1.1 (In); also elsewhere on the board
GND: Analog Input 1.2 (Ext), Analog Input 2.2 (Ext), Analog Output 1.2 (Ext), Analog Output 2.2 (Ext); also elsewhere on the board
