yusufElnady/NadyScope/(commit log)

2026-03-24 first commit, started the ADC section and selected main components
    [ADC.kicad_sch, DAC.kicad_sch, LOGIC_ANALYZER.kicad_sch, MCU.kicad_sch, NadyScope.kicad_pcb, NadyScope.kicad_sch, POWER.kicad_sch]
2026-03-24 increased attenuation settings to 4 but decreased channels to 1
    [ADC.kicad_sch]
2026-03-25 finished ADC side, may add some additional bare channels, started DAC part and need to add the tca0372 amplifier or think about it
    [ADC.kicad_sch, ADC_filters.kicad_sch, DAC.kicad_sch, MCU.kicad_sch, NadyScope.kicad_sch, attenuators.kicad_sch]
2026-04-09 80% done, maybe add more AINs, finish the power circuit and add system & block diagrams
    [ADC.kicad_sch, ADC_filters.kicad_sch, DAC.kicad_sch, DAC_filters.kicad_sch, LOGIC_ANALYZER.kicad_sch, MCU.kicad_sch, NadyScope.kicad_sch, POWER.kicad_sch]
2026-04-16 finished individual block placement and started integrating, might need to change the AFEs length
    [ADC.kicad_sch, ADC_filters.kicad_sch, DAC.kicad_sch, DAC_filters.kicad_sch, LOGIC_ANALYZER.kicad_sch, MCU.kicad_sch, NadyScope.kicad_pcb, NadyScope.kicad_sch]
2026-04-17 DONE, ready for ordering
    [MCU.kicad_sch, NadyScope.kicad_pcb, NadyScope.kicad_sch]
